mcer12/Temper-ESP8266/Images/webconfig.png

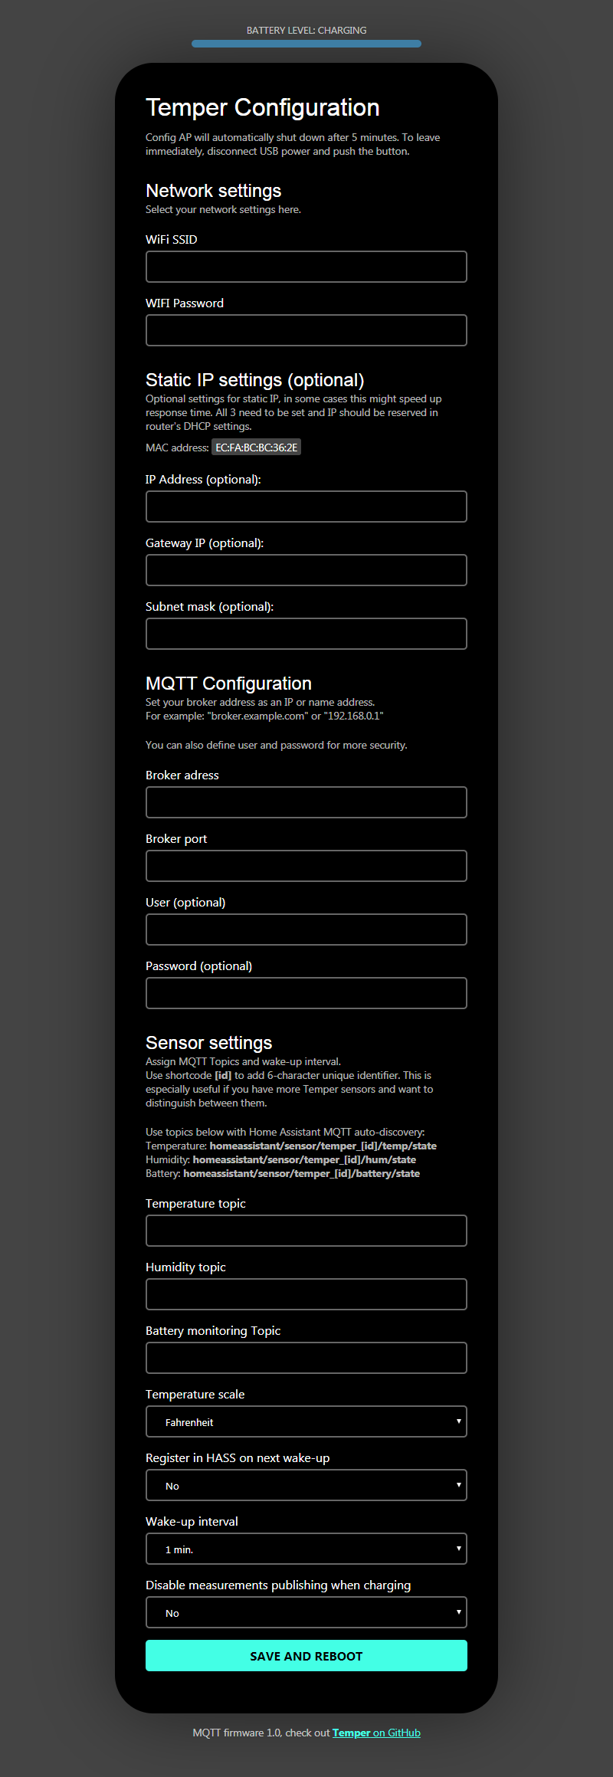
Images/webconfig.png
