mcer12/Temper-ESP8266/Images/with_cover_blue.jpg

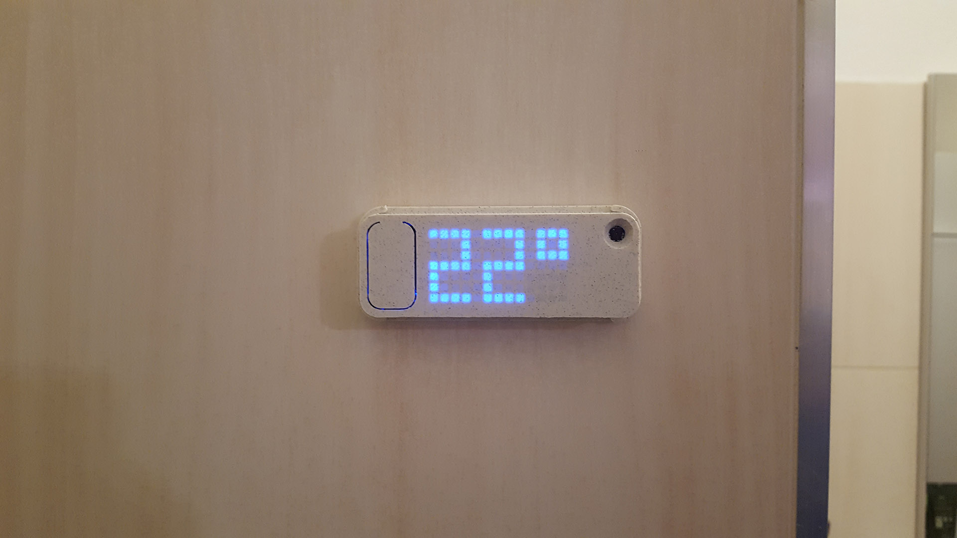
Images/with_cover_blue.jpg
