mcer12/Temper-ESP8266/PCB and BOM/IMPORTANT_components_information.xlsx

IMPORTANT ASSEMBLY NOTES:
1) Please note that some of the components are not available for JLCPCB assembly. You will have to order those separatery and solder them yourself. Everything can be ordered from LCSC (see lcsc part numbers below) or Ali.
2) If you order JLCPCB assembly, make sure they position display LEDs with cathodes (-) pointing to bottom left as it's not obvious from the silk screen.
3) Their components placement previewer is totally off, don't freak out when you see components placed randomly on the pcb, they will fix it later after you place the order. Just make sure about 2)
ID | component | package | LCSC part no. | amount | Supported by JLCPCB Assembly | notes
S1,S2,S3 | 74HC595 | SOIC-16 / SOP-16 | C5947 (https://lcsc.com/product-detail/74-Series_Nexperia_74HC595D-118_74HC595D-118_C5947.html/?href=jlc-SMT) | 3 | YES | There are plenty of clones, Nexperia ones worked for me (other brands can have higher power consumption).
B1 | tactile button | SMD-SW-4_5.1x5.1x1.5 | C318884 (https://lcsc.com/product-detail/Tactile-Switches_XKB-Enterprise-TS-1187-B-A-A_C318884.html/?href=jlc-SMT) | 1 | YES | https://lcsc.com/product-detail/Tactile-Switches_XKB-Enterprise-TS-1187A-B-A-B_C318884.html
 |  |  |  |  |  | https://www.aliexpress.com/item/32867219502.html?spm=a2g0s.9042311.0.0.27424c4dGV2Cyg
LDO | LDO | SOT-23 | C5446 (https://lcsc.com/product-detail/Low-Dropout-Regulators-LDO_XC6206P332MR_C5446.html/?href=jlc-SMT) | 1 | YES | MCP1700T, XC6206 also worked for me even though it's borderline with maximum current
R2 | resistor 680k | 0603 | C25822 (https://lcsc.com/product-detail/Chip-Resistor-Surface-Mount_Uniroyal-Elec-0603WAF6803T5E_C25822.html/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) | 1 | YES | R1 + R2 are voltage divider used for battery sensing, high resistance for low power consumption
R1 | resistor 200k | 0603 | C25811 (https://lcsc.com/product-detail/Chip-Resistor-Surface-Mount_Uniroyal-Elec-0603WAF2003T5E_C25811.html/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) | 1 | YES
C1,C2,C6,C7 | ceramic 10uF | 0603 | C19702 (https://lcsc.com/product-detail/Multilayer-Ceramic-Capacitors-MLCC-SMD-SMT_SAMSUNG_CL10A106KP8NNNC_10uF-106-10-10V_C19702.html/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) | 4 | YES | LDO capacitors (C1,C2) are recommended at 1uF, used 10uF without issues with both MCP1700 and XC6206
F1-F7 | n-fet | SOT-23 | C20917 (https://lcsc.com/product-detail/MOSFET_Alpha-Omega-Semicon_AO3400A_Alpha-Omega-Semicon-AOS-AO3400A_C20917.html/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) | 7 | YES | AO3400 or similar n-channel fet
R3,R4,R5,R6 | resistor 10k | 0603 | C25804 (https://lcsc.com/product-detail/Chip-Resistor-Surface-Mount_Uniroyal-Elec-0603WAF1002T5E_C25804.html/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) | 4 | YES | R7 (TP4054 charge current resistor, check the datasheet, 10k = 100mA charging current)
SHT | SHT30 | DFN_8 | C77361 (https://lcsc.com/product-detail/Temperature-Humidity-Sensors_Sensirion_SHT30-DIS-B_Sensirion-SHT30-DIS-B_C77361.html) | 1 | NO | https://lcsc.com/product-detail/Temperature-Humidity-Sensors_Sensirion_SHT30-DIS-B_Sensirion-SHT30-DIS-B_C77361.html
 |  |  |  |  |  | https://www.aliexpress.com/item/33014235546.html?spm=a2g0s.9042311.0.0.27424c4dxeyWfg
A1,A2,A3,A4 | resistor array 100R | 0603_x4 | C12003 (https://lcsc.com/product-detail/Resistor-Networks-Arrays_Uniroyal-Elec-4D03WGJ0201T5E_C12003.html/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) | 4 | YES | each led is ON 1/7 of time + some delays so resistor should be about 0.1 * recommended value. 100R proved OK for blue, white and bright green leds. Use lower value for red / orange. Brightness can always be lowered in the sketch
D1,D2 | schottky diode | SOD-323 | C191023 (https://lcsc.com/product-detail/Others_B5819WS_C191023.html/?href=jlc-SMT) | 2 | YES | 1N5819WS or similar, one of the diodes is at the bottom so it can’t be assembled by JLCPCB
C3,C4,C5 | ceramic 100nF | 0603 | C14663 (https://lcsc.com/product-detail/Multilayer-Ceramic-Capacitors-MLCC-SMD-SMT_100nF-104-10-50V_C14663.html/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) | 3 | YES
L1 | charging led | 0603 | C2286 (https://lcsc.com/product-detail/Light-Emitting-Diodes-LED_Hubei-KENTO-Elec-KT-0603R_C2286.html/?href=jlc-SMT) | 1 | YES | red or other LED, lights up when charging, turns off when charging is finished
R7 | resistor 1k | 0603 | C21190 (https://lcsc.com/product-detail/Chip-Resistor-Surface-Mount_Uniroyal-Elec-0603WAF1001T5E_C21190.html/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) | 1 | YES | 1k for red / orange, 2k for blue (connected to 5V rail)
U1 | TP4054 | SOT-23-5 | C32574 (https://lcsc.com/product-detail/PMIC-Battery-Management_TP4054_C32574.html/?href=jlc-SMT) |  | YES | TP4054 or a clone
F8 | P-fet | SOT-23 | C15127 (https://lcsc.com/product-detail/MOSFET_Alpha-Omega-Semicon_AO3401A_Alpha-Omega-Semicon-AOS-AO3401A_C15127.html/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) | 1 | YES | AO3401 or similar n-channel fet
ESP | ESP-12 | - | C82898 (https://lcsc.com/product-detail/WIFI-Modules_ESP-12S_C82898.html) |  | YES | any type of ESP-12 will do
USB | microusb connector | - | C10418 | 1 | NO | https://lcsc.com/product-detail/USB-Connectors_Jing-Extension-of-the-Electronic-Co-Jing-Extension-of-the-Electronic-Co-MICRO-USB-5S-B-Type-horns-High-temperat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
 |  |  | C319164 |  |  | https://lcsc.com/product-detail/USB-Connectors_XKB-Enterprise-U254-051T-4BH23-S2B_C319164.html
 |  |  |  |  |  | https://www.aliexpress.com/item/32966138542.html?spm=a2g0s.9042311.0.0.27424c4dXU2s0p
 |  |  |  |  |  | https://www.aliexpress.com/item/32848314580.html?spm=a2g0s.9042311.0.0.27424c4dXU2s0p
- | Display leds | 0603 | C72043 (https://lcsc.com/product-detail/Light-Emitting-Diodes-LED_0603-Green-light_C72043.html/?href=jlc-SMT) | 91 | YES | bright green or blue are most efficient and easily visible They are also the cheapest.
- | LiPo battery | 502050 | x | 1 | NO | this or similar, slightly larger battery will also fit.
 |  |  |  |  |  | https://www.aliexpress.com/item/32797618620.html?spm=a2g0s.9042311.0.0.27424c4dcRtysh
- | JST 1.25mm 2pin | JST1.25-02-RM | C442099 (https://lcsc.com/product-detail/Wire-To-Board-Wire-To-Wire-Connector_HX-Zhejiang-Yueqing-Hongxing-Elec-HX12501-2AWB_C442099.html) | 1 | NO | This is not required, you can use pads at the back of the pcb to solder battery leads directly.
 |  |  |  |  |  | https://lcsc.com/product-detail/Wire-To-Board-Wire-To-Wire-Connector_HX-Zhejiang-Yueqing-Hongxing-Elec-HX12501-2AWB_C442099.html
 |  |  |  |  |  | https://www.aliexpress.com/item/32787273682.html?spm=a2g0s.9042311.0.0.27424c4diugtNU
