mcer12/Temper-ESP8266/(threads)

Thread 1 (2020-01-29):

Request to share schematic

Jianan-Li, 2020-01-29:
Would you be willing to share the schematic for this project? Thanks for your consideration!

mcer12, 2020-01-29:
Thanks for the interest in the project, I will make sure to add the schematic asap. Will notify you in this issue once that's done.

mcer12, 2020-01-30:
Schematic added :) Sorry I took a bit longer with it, I had to redraw it as the original one was a mess and this one resembles pcb layout a bit better. Hopefully I didn't make any errors... if you find anything questionable in it, let me know.

moosepants, 2020-08-03:
Hey I see you added the schematic PDF and gerbers... is it too much to ask for the CAD versions? I really like this project, but would like to make a couple of tweaks (e.g. replace the reset button with an IR Prox sensor) before I send to PCB fab...

mcer12, 2020-08-04:
I made this in EasyEDA, here's the source. Let me know if you have issues viewing it but it should be public and ready to clone.
https://bit.ly/2PoQ4QE

mcer12, 2020-08-04:
And don't forget to take a look at design suggestions on wiki page if you plan on tinkering with the design ;)

moosepants, 2020-08-04:
Thanks very much! I saw the wiki page and will make the suggested updates.  Cheers 👍

Closed 2020-01-30.

Thread 2 (2020-01-29):

Feature request : uMQTT broker

happytm, 2020-01-29:
This is stunning hardware and software combination. It would be even better if excellent uMQTT broker is implemented on the device itself so we can access sensor data by using just MQTT Dash app from smartphone. This eliminate need for cloud MQTT broker or local linux device to host MQTT broker. Links are below:

original library:
https://github.com/martin-ger/uMQTTBroker

My implementation simple IOT network using above library:
https://github.com/happytm/BatteryNode

Android App to view sensor data:
https://play.google.com/store/apps/details?id=net.routix.mqttdash&hl=en_US

Thanks.

mcer12, 2020-01-29:
Hi @happytm If I understand this correctly, it would mean for the device to stay always ON as a broker and to respond to any potential request from the app. That would drop battery life from months to just a few hours. So for this device, it doesn't make much sense. Or did you have something else in mind?

happytm, 2020-01-29:
If you look at my repository there are 2 sketches. One is called ProbeReceiver.ino which is master for whole network and it has to be mains powered.I would like to use uMQTT broker on this master device. Rest of the devices uses ProbeSender.ino sketch and they are battery powered. These devices send data to master device even without connecting to it. With these devices it takes only between 50 to 60 milliseconds to send data to master and master is passing this data via uMQTT broker to MQTT Dash app mentioned above. I tried to create most power efficient, cost effective and simplest IOT network using ESP8266 devices and I have not yet come across any IOT network which can do all of these. I tried ESPNow protocol but it can not use the protocol and wifi together. I also tried LORA network but it is not simple or cost effective. Please try it using 2 esp8266 devices - one master and one slave - to realize the potential. One thing my code missing is nice user interface you have and I was hoping to use it for my project.

Thanks.

mcer12, 2020-01-29:
I don't see why it wouldn't work with uMQTT broker just like any other MQTT broker. What are the reasons you don't just use MQTT? The sketch in the link seems rather complicated.

happytm, 2020-01-29:
Yes the sketch looks complicated but it uses lot of serial debugging code for newbies like me. That's the reason I wanted to have nice UI so user can just upload .bin files provided and set all variable required using UI. I wanted truly standalone network so it can be totally local without requiring any real wifi access point or internet connection for local control and at the same time accessible from anywhere in the world using MQTT client app on smartphone if internet is available at the network location.

Thanks.

mcer12, 2020-01-30:
I see... Well I made this as a MQTT device because I use MQTT myself. I won't be implementing other protocols / platforms unless I personally migrate to them, hope you understand. If you would like to contribute, I will gladly accept any PRs. That said, if you find the UI nice, feel free to grab the code and implement it in your project (as long as it's non-commercial ;)

happytm, 2020-01-30:
Thank you for your response.

Closed 2020-01-31.
