mcer12/Temper-ESP8266/Schematic/Schematic_Temper-ESP8266.pdf

## Battery voltage measurement

## SHT30

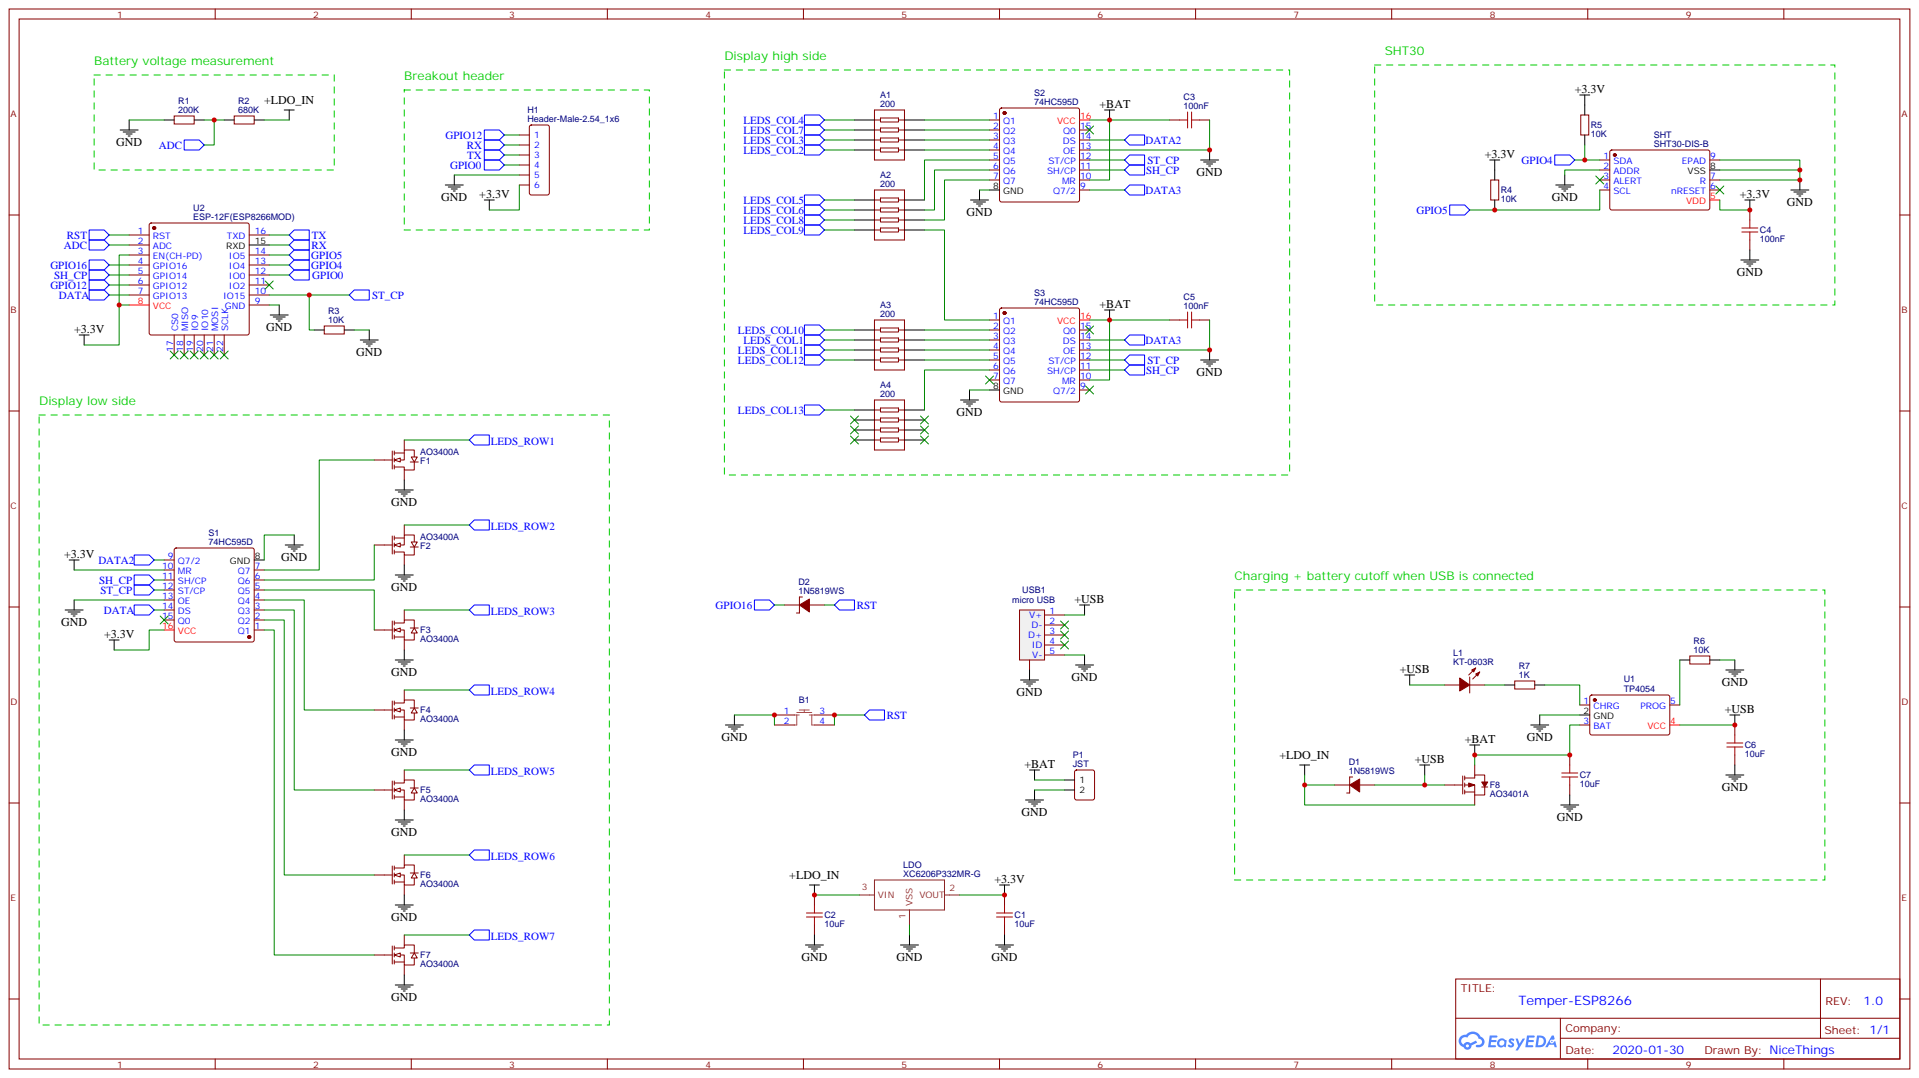
[picture p5: page 1]

Charging + battery cutoff when USB is connected
