mcer12/Temper-ESP8266/Firmware/Temper_MqttSensor/fonts.ino

uint8_t digitsLarge[10][7][4] = {
  {
    {1, 1, 1, 1,},
    {1, 0, 0, 1,},
    {1, 0, 0, 1,},
    {1, 0, 0, 1,},
    {1, 0, 0, 1,},
    {1, 0, 0, 1,},
    {1, 1, 1, 1,},
  },
  {
    {0, 0, 0, 1,},
    {0, 0, 0, 1,},
    {0, 0, 0, 1,},
    {0, 0, 0, 1,},
    {0, 0, 0, 1,},
    {0, 0, 0, 1,},
    {0, 0, 0, 1,},
  },
  {
    {1, 1, 1, 1,},
    {0, 0, 0, 1,},
    {0, 0, 0, 1,},
    {1, 1, 1, 1,},
    {1, 0, 0, 0,},
    {1, 0, 0, 0,},
    {1, 1, 1, 1,},
  },
  {
    {1, 1, 1, 1,},
    {0, 0, 0, 1,},
    {0, 0, 0, 1,},
    {1, 1, 1, 1,},
    {0, 0, 0, 1,},
    {0, 0, 0, 1,},
    {1, 1, 1, 1,},
  },
  {
    {1, 0, 0, 1,},
    {1, 0, 0, 1,},
    {1, 0, 0, 1,},
    {1, 1, 1, 1,},
    {0, 0, 0, 1,},
    {0, 0, 0, 1,},
    {0, 0, 0, 1,},
  },
  {
    {1, 1, 1, 1,},
    {1, 0, 0, 0,},
    {1, 0, 0, 0,},
    {1, 1, 1, 1,},
    {0, 0, 0, 1,},
    {0, 0, 0, 1,},
    {1, 1, 1, 1,},
  },
  {
    {1, 1, 1, 1,},
    {1, 0, 0, 0,},
    {1, 0, 0, 0,},
    {1, 1, 1, 1,},
    {1, 0, 0, 1,},
    {1, 0, 0, 1,},
    {1, 1, 1, 1,},
  },
  {
    {1, 1, 1, 1,},
    {0, 0, 0, 1,},
    {0, 0, 0, 1,},
    {0, 0, 0, 1,},
    {0, 0, 0, 1,},
    {0, 0, 0, 1,},
    {0, 0, 0, 1,},
  },
  {
    {1, 1, 1, 1,},
    {1, 0, 0, 1,},
    {1, 0, 0, 1,},
    {1, 1, 1, 1,},
    {1, 0, 0, 1,},
    {1, 0, 0, 1,},
    {1, 1, 1, 1,},
  },
  {
    {1, 1, 1, 1,},
    {1, 0, 0, 1,},
    {1, 0, 0, 1,},
    {1, 1, 1, 1,},
    {0, 0, 0, 1,},
    {0, 0, 0, 1,},
    {1, 1, 1, 1,},
  },
};

uint8_t digitsSmall[10][5][3] = {
  {
    {1, 1, 1,},
    {1, 0, 1,},
    {1, 0, 1,},
    {1, 0, 1,},
    {1, 1, 1,},
  },
  {
    {0, 0, 1,},
    {0, 0, 1,},
    {0, 0, 1,},
    {0, 0, 1,},
    {0, 0, 1,},
  },
  {
    {1, 1, 1,},
    {0, 0, 1,},
    {1, 1, 1,},
    {1, 0, 0,},
    {1, 1, 1,},
  },
  {
    {1, 1, 1,},
    {0, 0, 1,},
    {1, 1, 1,},
    {0, 0, 1,},
    {1, 1, 1,},
  },
  {
    {1, 0, 1,},
    {1, 0, 1,},
    {1, 1, 1,},
    {0, 0, 1,},
    {0, 0, 1,},
  },
  {
    {1, 1, 1,},
    {1, 0, 0,},
    {1, 1, 1,},
    {0, 0, 1,},
    {1, 1, 1,},
  },
  {
    {1, 1, 1,},
    {1, 0, 0,},
    {1, 1, 1,},
    {1, 0, 1,},
    {1, 1, 1,},
  },
  {
    {1, 1, 1,},
    {0, 0, 1,},
    {0, 0, 1,},
    {0, 0, 1,},
    {0, 0, 1,},
  },
  {
    {1, 1, 1,},
    {1, 0, 1,},
    {1, 1, 1,},
    {1, 0, 1,},
    {1, 1, 1,},
  },
  {
    {1, 1, 1,},
    {1, 0, 1,},
    {1, 1, 1,},
    {0, 0, 1,},
    {1, 1, 1,},
  },
};
