mcer12/Temper-ESP8266/(commit log)

2020-01-20 beta, missing sleep time option
    [Temper_MqttSensor.ino, config_portal.ino, fns.ino, fonts.ino, hass_register.ino, screen_fns.ino, sensor.ino]
2020-01-21 tested & working beta, needs tweeking of buttonWakeUp() function
2020-01-23 fix to be able to exit Config portal by hard reset while connected to USB
    [config_portal.ino]
2020-01-25 FW edits, fixed display stutter when going to sleep
    [Temper_MqttSensor.ino, fns.ino]
2020-01-25 Gerber, BOM, Pick&Place and some images
    [BOM_Temper-ESP8266.xlsx, PickAndPlace_Temper-ESP8266.xlsx, TEMPER_components_information.xlsx]
2020-01-25 components info update, files renamed
    [IMPORTANT_components_information.xlsx, JLCPCB_ASSEMBLY_BOM_Temper-ESP8266.xlsx, JLCPCB_ASSEMBLY_PickAndPlace_Temper-ESP8266.xlsx, TEMPER_components_information.xlsx]
2020-01-25 JLCPCB assembly notes added to components information
    [IMPORTANT_components_information.xlsx]
2020-01-25 gerber update
2020-01-26 updated components info
    [IMPORTANT_components_information.xlsx]
2020-01-30 Schematic 1.0
2020-09-21 fixed humidity debug print
    [Temper_MqttSensor.ino]
